liquid-rocketry-illinois/HAL-1-HW/KiCAD/Added_Footprints/BMI270/BMI323/BMI323.step

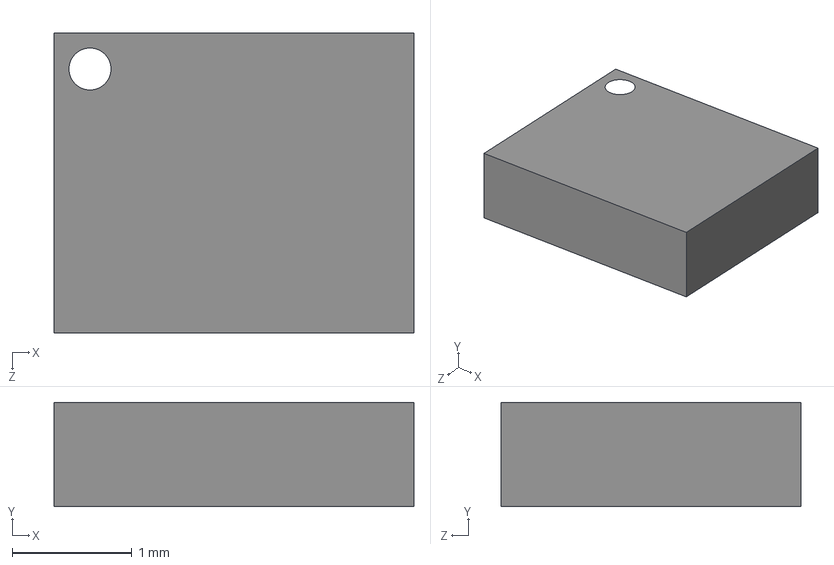
[picture p1: CAD file, 2026-01-19]
KiCAD/Added_Footprints/BMI270/BMI323/BMI323.step
3.00 x 0.87 x 2.50 mm
