liquid-rocketry-illinois/HAL-1-HW/(list of files, cad)

Other CAD files:
AV Bay CAD/AVBayAssembly.prt
AV Bay CAD/AVBayV2_BasePlate.prt
AV Bay CAD/AVBayV2_TopPlate.prt
AV Bay CAD/Antenna.prt
AV Bay CAD/Battery.prt
AV Bay CAD/Battery_Case_v2.prt
AV Bay CAD/Battery_Constrainer_v1.prt
AV Bay CAD/Battery_Plate.prt
AV Bay CAD/Done/AVBayV2_BasePlate.prt
AV Bay CAD/Done/AVBayV2_TopPlate.prt
AV Bay CAD/HAL-1_Case.prt
AV Bay CAD/Obseleted/[V1 Obselete] Board_Mounts.prt
AV Bay CAD/Screw_Switch.prt
AV Bay CAD/Telemega_Case.prt
