liquid-rocketry-illinois/HAL-1-HW/KiCAD/Soldering Practice Board/Main/Main.kicad_pcb

## KiCad design KiCAD/Soldering Practice Board/Main/Main.kicad_pcb (2026-03-03)

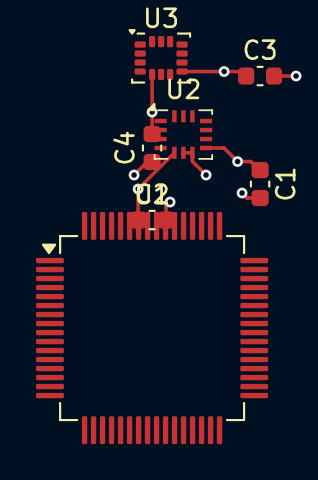
[picture p2: board KiCAD/Soldering Practice Board/Main/Main.kicad_pcb from above]

Board: 2 copper layers, 7 parts (0 on the bottom side), 2 nets.

Parts:
C1, C2, C3, C4: 100n; C_0603_1608Metric
U1: STM32C071R8Tx; LQFP-64_10x10mm_P0.5mm
U2: BMI160; Bosch_LGA-14_3x2.5mm_P0.5mm
U3: LSM6DS3; LGA-14_3x2.5mm_P0.5mm_LayoutBorder3x4y

Connections:
+3V3: C1.1, C2.1, C3.1, C4.2, U1.7 (VREF+), U1.8 (VDD), U2.5 (VDDIO), U2.8 (VDD), U3.5 (VDDIO), U3.8 (VDD)
GND: C1.2, C2.2, C3.2, C4.1, U1.9 (VSS), U2.6 (GNDIO), U2.7 (GND), U3.2 (SDX), U3.3 (SCX), U3.6 (GND), U3.7 (GND)
