liquid-rocketry-illinois/HAL-1-HW/KiCAD/Main/Main.kicad_pcb

## KiCad design KiCAD/Main/Main.kicad_pcb (2026-02-15)

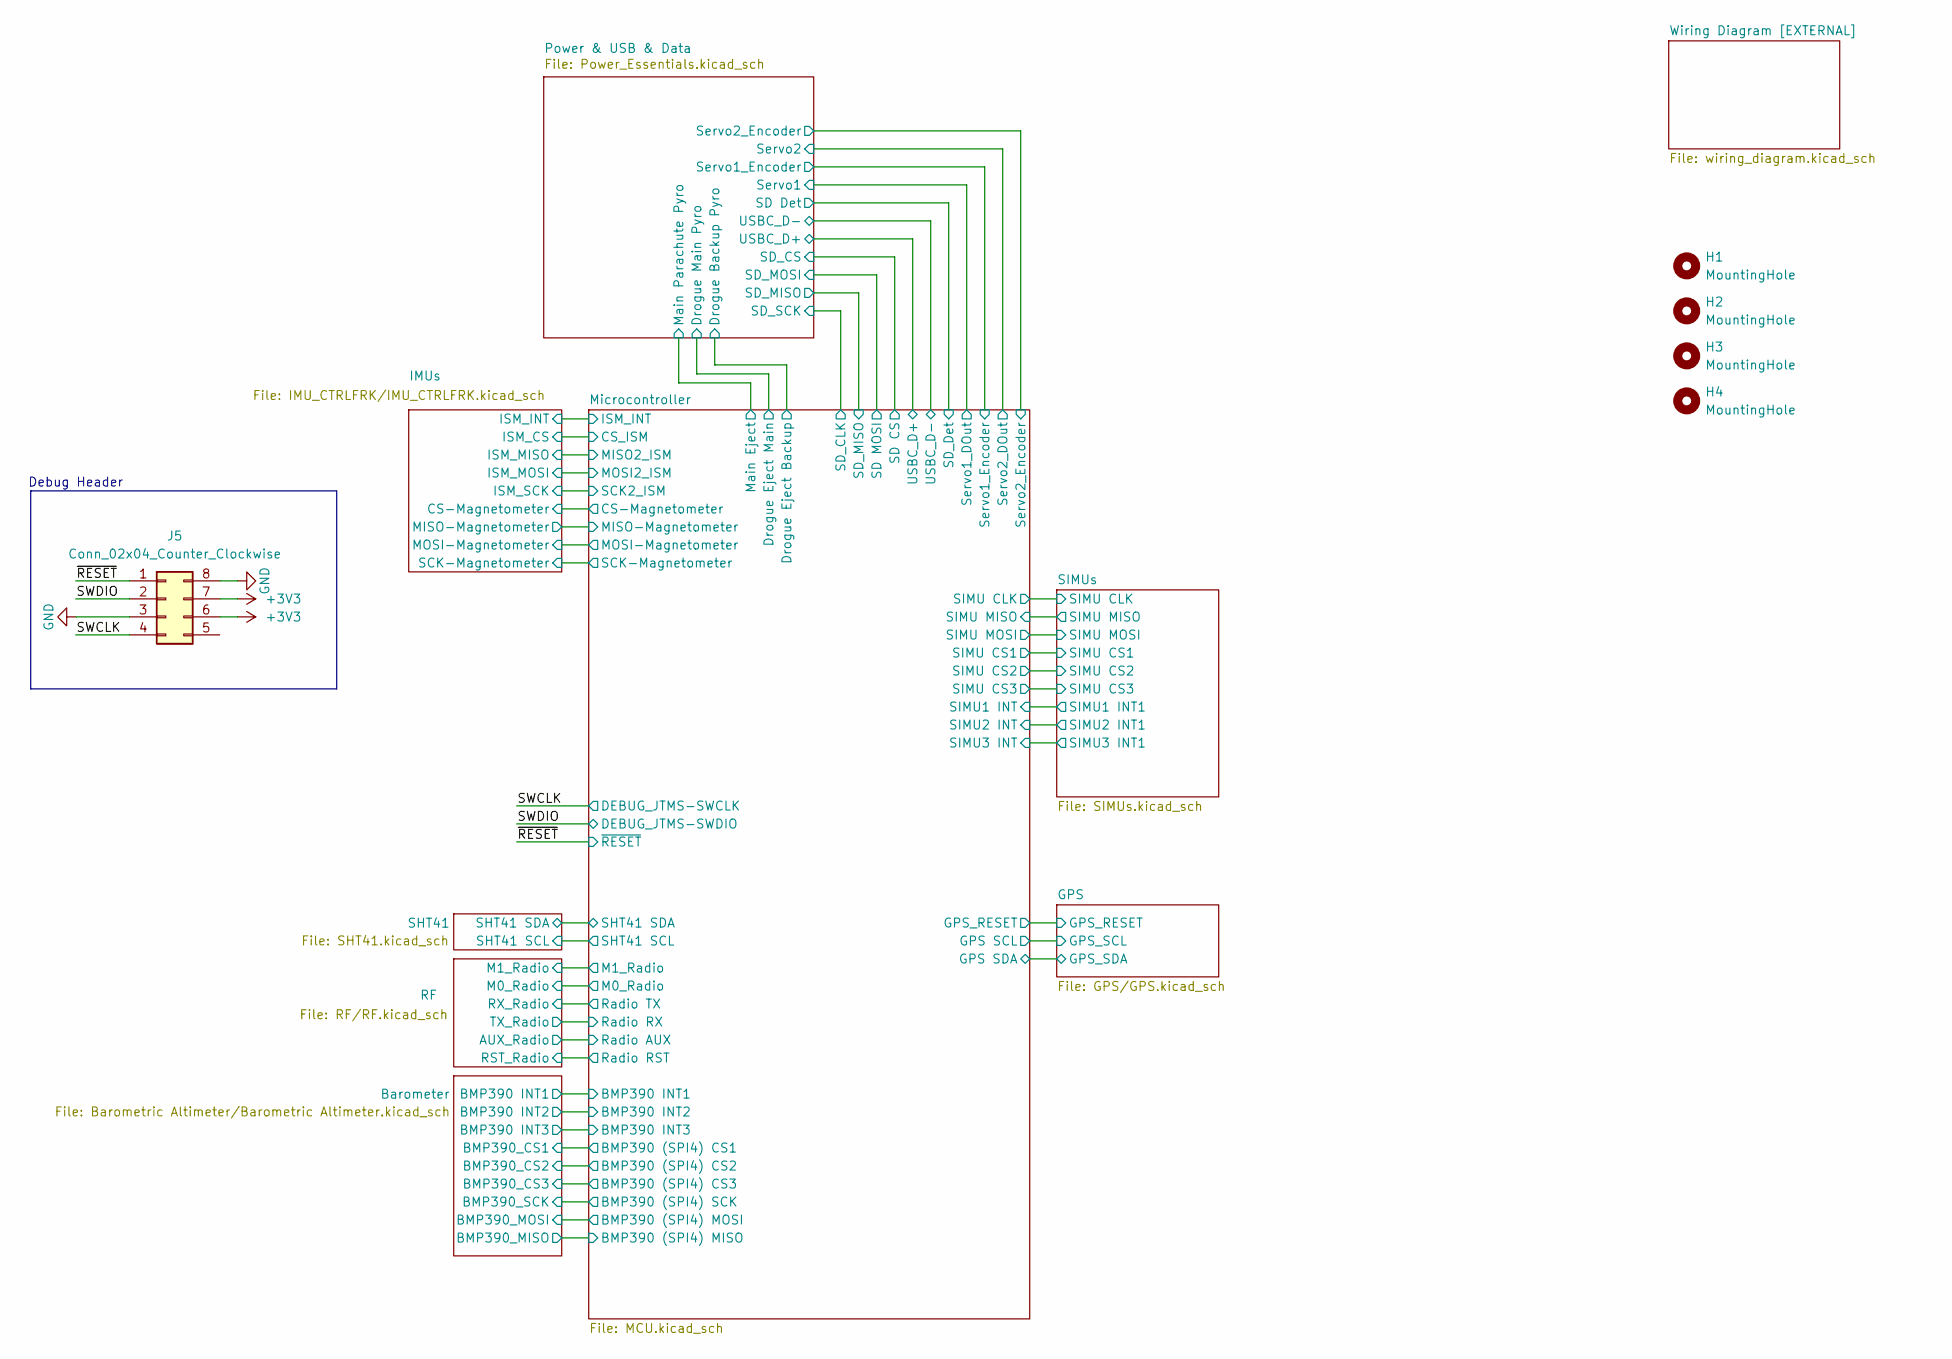
[picture p3: schematic Main.kicad_sch]

Parts:
H1, H2, H3, H4: MountingHole; MountingHole_3.2mm_M3
J5: Conn_02x04_Counter_Clockwise; PinHeader_2x04_P2.54mm_Vertical

Connections:
+3V3: J5.6, J5.7; also elsewhere on the board
/SWCLK: J5.4; also elsewhere on the board
/SWDIO: J5.2; also elsewhere on the board
/~RESET: J5.1; also elsewhere on the board
GND: J5.3, J5.8; also elsewhere on the board

Notes on the sheet:
Debug Header

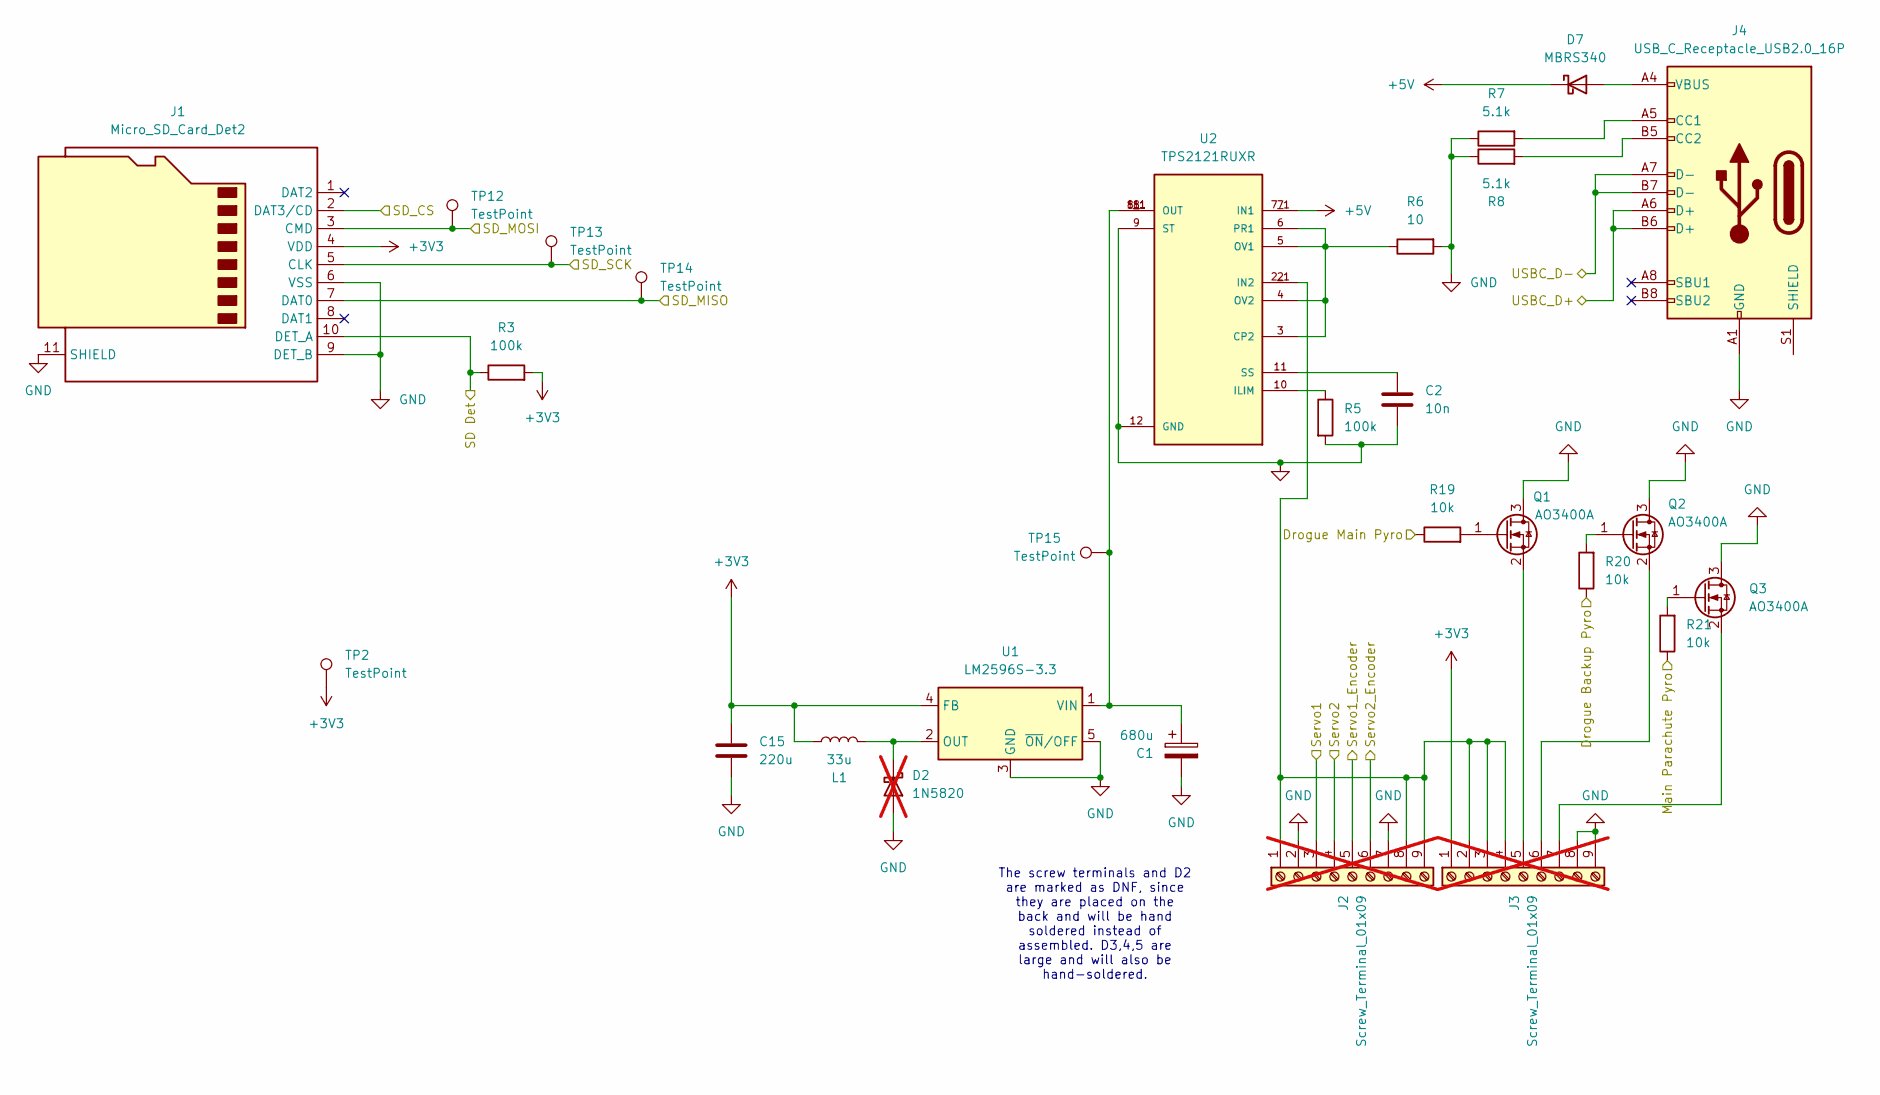
[picture p4: schematic Power_Essentials.kicad_sch]

Parts:
C1: 680u; CP_Elec_10x12.6
C2: 10n; C_0603_1608Metric
C15: 220u; C_1206_3216Metric
D2: 1N5820; D_DO-201AD_P15.24mm_Horizontal; not fitted
D7: MBRS340; D_SMC
J1: Micro_SD_Card_Det2; microSD_HC_Hirose_DM3AT-SF-PEJM5
J2, J3: Screw_Terminal_01x09; TerminalBlock_Phoenix_MKDS-1,5-9_1x09_P5.00mm_Horizontal; not fitted
J4: USB_C_Receptacle_USB2.0_16P; USB_C_Receptacle_HRO_TYPE-C-31-M-12
L1: 33u; L_SXN_SMDRI127
Q1, Q2, Q3: AO3400A; SOT-23
R3, R5: 100k; R_0603_1608Metric
R6: 10; R_0603_1608Metric
R7, R8: 5.1k; R_0603_1608Metric
R19, R20, R21: 10k; R_0603_1608Metric
TP2, TP12, TP13, TP14, TP15: TestPoint; TestPoint_Pad_D1.0mm
U1: LM2596S-3.3; TO-263-5_TabPin3
U2: TPS2121RUXR; Texas_VQFN-HR-12_2x2.5mm_P0.5mm_ThermalVias

Connections:
+3V3: C15.1, J1.4 (VDD), J3.1 (3V3_OUT), L1.1, R3.2, TP2.1, U1.4 (FB); also elsewhere on the board
+5V: D7.1 (K), U2.7 (IN1), U2.7_1 (IN1)
/Microcontroller/Drogue Eject Backup: R20.1; also elsewhere on the board
/Microcontroller/Drogue Eject Main: R19.1; also elsewhere on the board
/Microcontroller/Main Eject: R21.1; also elsewhere on the board
/Microcontroller/SD CS: J1.2 (DAT3/CD); also elsewhere on the board
/Microcontroller/SD MOSI: J1.3 (CMD), TP12.1; also elsewhere on the board
/Microcontroller/SD_CLK: J1.5 (CLK), TP13.1; also elsewhere on the board
/Microcontroller/SD_Det: J1.10 (DET_A), R3.1; also elsewhere on the board
/Microcontroller/SD_MISO: J1.7 (DAT0), TP14.1; also elsewhere on the board
/Microcontroller/Servo1_DOut: J2.3 (Servo1); also elsewhere on the board
/Microcontroller/Servo1_Encoder: J2.5 (Servo1_Encoder); also elsewhere on the board
/Microcontroller/Servo2_DOut: J2.4 (Servo2); also elsewhere on the board
/Microcontroller/Servo2_Encoder: J2.6 (Servo2_Encoder); also elsewhere on the board
/Microcontroller/USBC_D+: J4.A6 (D+), J4.B6 (D+); also elsewhere on the board
/Microcontroller/USBC_D-: J4.A7 (D-), J4.B7 (D-); also elsewhere on the board
GND: C1.2, C2.2, C15.2, D2.2 (A), J1.6 (VSS), J1.9 (DET_B), J1.11 (SHIELD), J2.2 (GND), J2.7 (MotorGND), J3.8, J3.9 (GND), J4.A1 (GND), J4.A12 (GND), J4.B1 (GND), J4.B12 (GND), Q1.3 (D), Q2.3 (D), Q3.3 (D), R5.2, R6.2, R7.1, R8.1, U1.3 (GND), U1.5 (~ON/OFF), U2.9 (ST), U2.12 (GND); also elsewhere on the board
unnamed: D2.1 (K), L1.2, U1.2 (OUT)
unnamed: D7.2 (A), J4.A4 (VBUS), J4.A9 (VBUS), J4.B4 (VBUS), J4.B9 (VBUS)
unnamed: J2.1 (7.4V_IN), J2.8 (MotorPwr1), J2.9 (MotorPwr2), J3.2 (Pyro_OUT_1), J3.3 (Pyro_OUT_2), J3.4 (Pyro_OUT_3), U2.2 (IN2), U2.2_1 (IN2)
unnamed: J3.6 (Drogue_Backup), Q2.2 (S)
unnamed: J3.5 (Drogue_Main), Q1.2 (S)
unnamed: J3.7 (Main_Parachute), Q3.2 (S)
unnamed: J4.A5 (CC1), R7.2
unnamed: J4.B5 (CC2), R8.2
unnamed: Q1.1 (G), R19.2
unnamed: Q2.1 (G), R20.2
unnamed: Q3.1 (G), R21.2
unnamed: C1.1, TP15.1, U1.1 (VIN), U2.1 (OUT), U2.1_1 (OUT), U2.8 (OUT), U2.8_1 (OUT)
unnamed: R6.1, U2.3 (CP2), U2.4 (OV2), U2.5 (OV1), U2.6 (PR1)
unnamed: R5.1, U2.10 (ILIM)
unnamed: C2.1, U2.11 (SS)

Notes on the sheet:
The screw terminals and D2 are marked as DNF, since they are placed on the back and will be hand soldered instead of assembled. D3,4,5 are large and will also be hand-soldered.

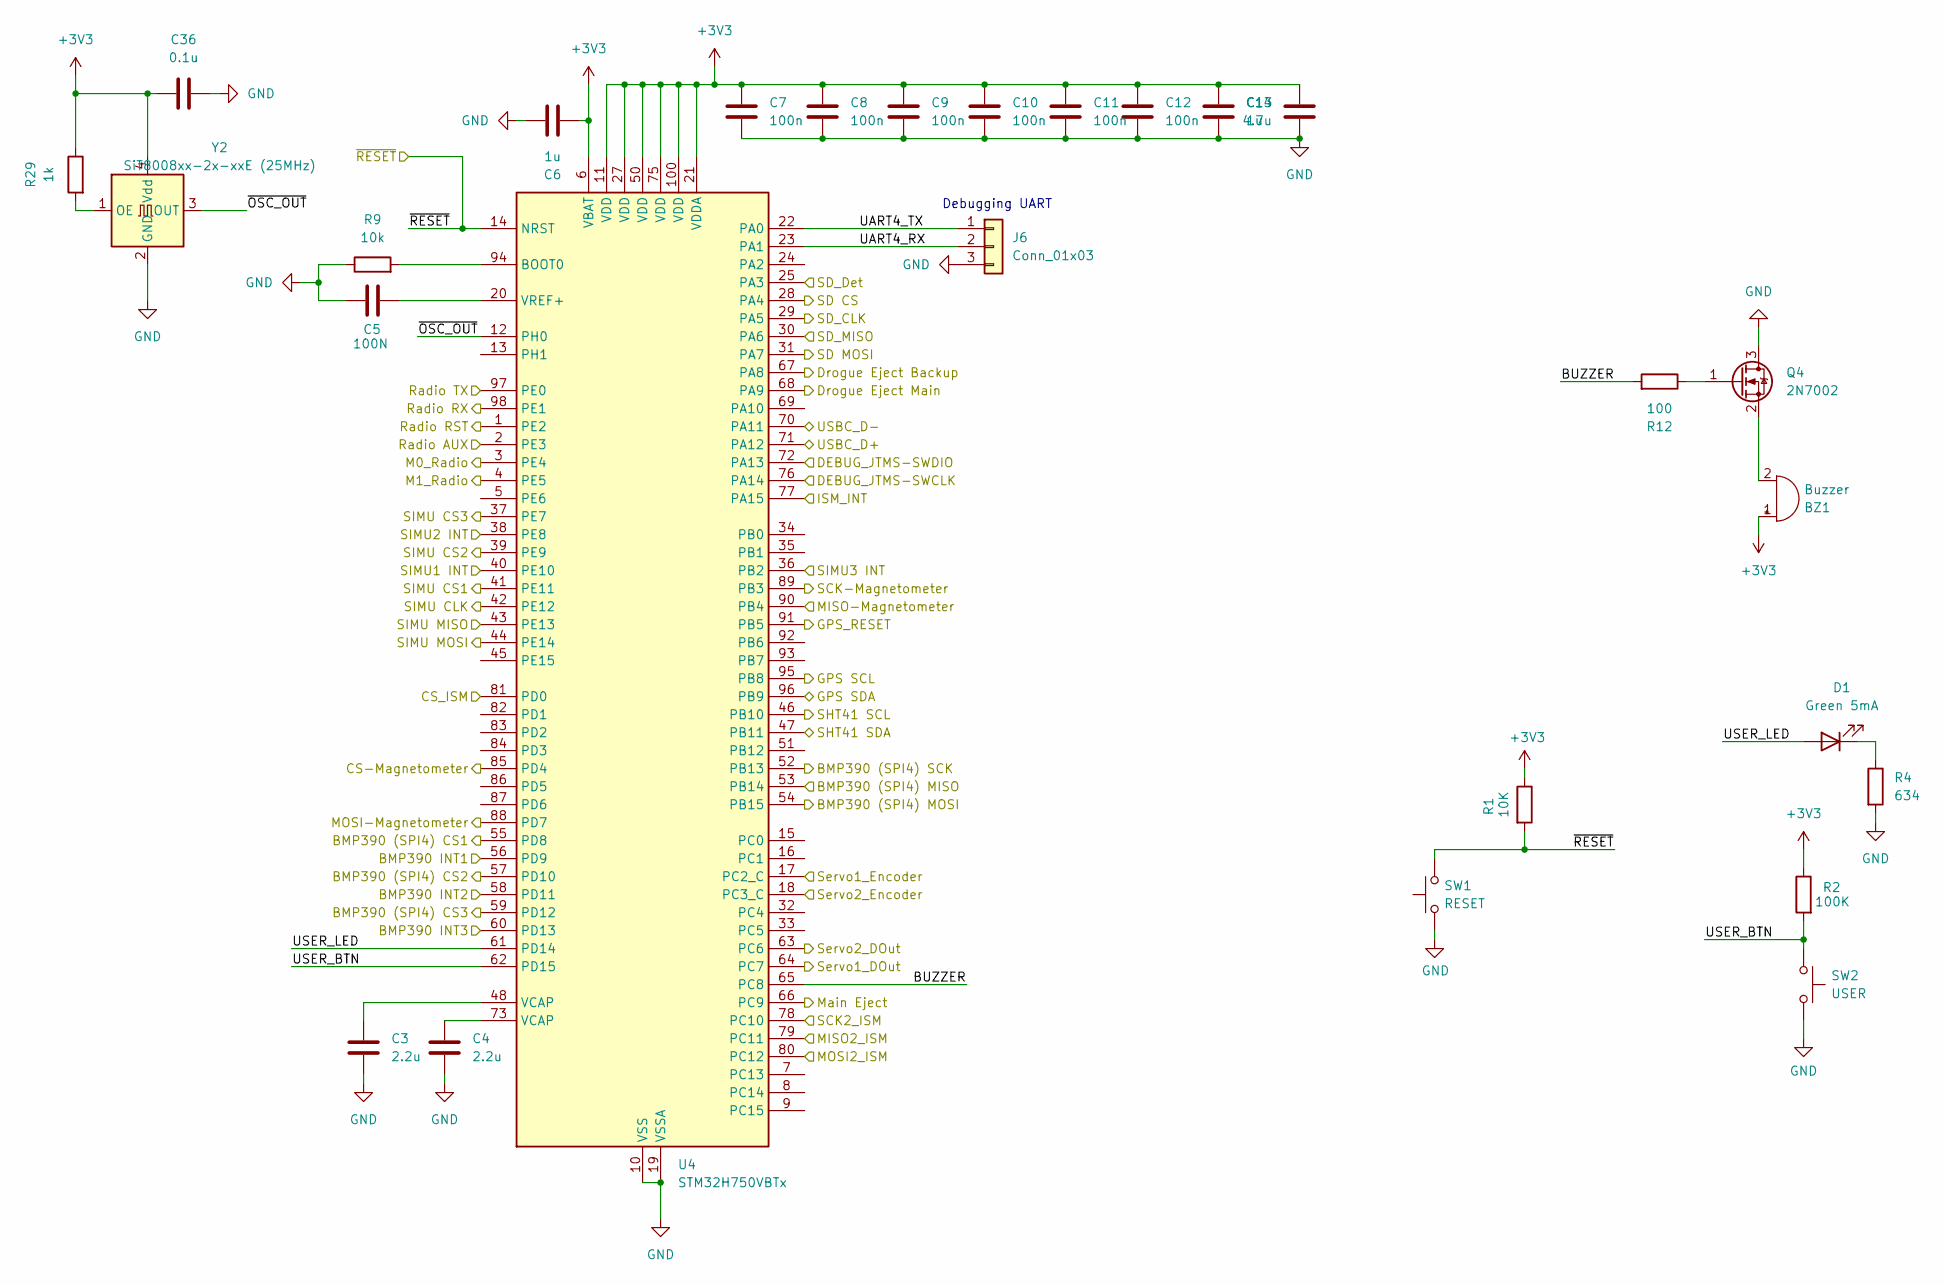
[picture p5: schematic MCU.kicad_sch]

Parts:
BZ1: Buzzer; Buzzer_12x9.5RM7.6
C3, C4: 2.2u; C_0603_1608Metric
C5: 100N; C_0603_1608Metric
C6, C13: 1u; C_0603_1608Metric
C7, C8, C9, C10, C11, C12: 100n; C_0603_1608Metric
C14: 4.7u; C_0603_1608Metric
C36: 0.1u; C_0603_1608Metric
D1: Green 5mA; LED_0603_1608Metric
J6: Conn_01x03; PinHeader_1x03_P2.54mm_Vertical
Q4: 2N7002; SOT-23
R1: 10K; R_0603_1608Metric
R2: 100K; R_0603_1608Metric
R4: 634; R_0603_1608Metric
R9: 10k; R_0603_1608Metric
R12: 100; R_0603_1608Metric
R29: 1k; R_0603_1608Metric
SW1: RESET; SW_Push_1P1T_NO_Vertical_Wuerth_434133025816
SW2: USER; SW_Push_1P1T_NO_Vertical_Wuerth_434133025816
U4: STM32H750VBTx; LQFP-100_14x14mm_P0.5mm
Y2: SiT8008xx-2x-xxE (25MHz); Oscillator_SMD_SiT_PQFN-4Pin_3.2x2.5mm

Connections:
+3V3: BZ1.1 (+), C6.2, C7.1, C8.1, C9.1, C10.1, C11.1, C12.1, C13.1, C14.1, C36.2, R1.1, R2.1, R29.1, U4.6 (VBAT), U4.11 (VDD), U4.21 (VDDA), U4.27 (VDD), U4.50 (VDD), U4.75 (VDD), U4.100 (VDD), Y2.4 (Vdd); also elsewhere on the board
/Barometer/BMP390 INT1: U4.56 (PD9); also elsewhere on the board
/Barometer/BMP390 INT2: U4.58 (PD11); also elsewhere on the board
/Barometer/BMP390 INT3: U4.60 (PD13); also elsewhere on the board
/Barometer/BMP390_CS1: U4.55 (PD8); also elsewhere on the board
/Barometer/BMP390_CS2: U4.57 (PD10); also elsewhere on the board
/Barometer/BMP390_CS3: U4.59 (PD12); also elsewhere on the board
/Barometer/BMP390_MISO: U4.53 (PB14); also elsewhere on the board
/Barometer/BMP390_MOSI: U4.54 (PB15); also elsewhere on the board
/Barometer/BMP390_SCK: U4.52 (PB13); also elsewhere on the board
/GPS/GPS_RESET: U4.91 (PB5); also elsewhere on the board
/GPS/GPS_SCL: U4.95 (PB8); also elsewhere on the board
/GPS/GPS_SDA: U4.96 (PB9); also elsewhere on the board
/IMUs/CS-Magnetometer: U4.85 (PD4); also elsewhere on the board
/IMUs/ISM_CS: U4.81 (PD0); also elsewhere on the board
/IMUs/ISM_INT: U4.77 (PA15); also elsewhere on the board
/IMUs/ISM_MISO: U4.79 (PC11); also elsewhere on the board
/IMUs/ISM_MOSI: U4.80 (PC12); also elsewhere on the board
/IMUs/ISM_SCK: U4.78 (PC10); also elsewhere on the board
/IMUs/MISO-Magnetometer: U4.90 (PB4); also elsewhere on the board
/IMUs/MOSI-Magnetometer: U4.88 (PD7); also elsewhere on the board
/IMUs/SCK-Magnetometer: U4.89 (PB3); also elsewhere on the board
/Microcontroller/BUZZER: R12.2, U4.65 (PC8)
/Microcontroller/Drogue Eject Backup: U4.67 (PA8); also elsewhere on the board
/Microcontroller/Drogue Eject Main: U4.68 (PA9); also elsewhere on the board
/Microcontroller/M0_Radio: U4.3 (PE4); also elsewhere on the board
/Microcontroller/M1_Radio: U4.4 (PE5); also elsewhere on the board
/Microcontroller/Main Eject: U4.66 (PC9); also elsewhere on the board
/Microcontroller/Radio AUX: U4.2 (PE3); also elsewhere on the board
/Microcontroller/Radio RST: U4.1 (PE2); also elsewhere on the board
/Microcontroller/Radio RX: U4.98 (PE1); also elsewhere on the board
/Microcontroller/Radio TX: U4.97 (PE0); also elsewhere on the board
/Microcontroller/SD CS: U4.28 (PA4); also elsewhere on the board
/Microcontroller/SD MOSI: U4.31 (PA7); also elsewhere on the board
/Microcontroller/SD_CLK: U4.29 (PA5); also elsewhere on the board
/Microcontroller/SD_Det: U4.25 (PA3); also elsewhere on the board
/Microcontroller/SD_MISO: U4.30 (PA6); also elsewhere on the board
/Microcontroller/SHT41 SCL: U4.46 (PB10); also elsewhere on the board
/Microcontroller/SHT41 SDA: U4.47 (PB11); also elsewhere on the board
/Microcontroller/SIMU1 INT: U4.40 (PE10); also elsewhere on the board
/Microcontroller/SIMU2 INT: U4.38 (PE8); also elsewhere on the board
/Microcontroller/SIMU3 INT: U4.36 (PB2); also elsewhere on the board
/Microcontroller/SIMU CLK: U4.42 (PE12); also elsewhere on the board
/Microcontroller/SIMU CS1: U4.41 (PE11); also elsewhere on the board
/Microcontroller/SIMU CS2: U4.39 (PE9); also elsewhere on the board
/Microcontroller/SIMU CS3: U4.37 (PE7); also elsewhere on the board
/Microcontroller/SIMU MISO: U4.43 (PE13); also elsewhere on the board
/Microcontroller/SIMU MOSI: U4.44 (PE14); also elsewhere on the board
/Microcontroller/Servo1_DOut: U4.64 (PC7); also elsewhere on the board
/Microcontroller/Servo1_Encoder: U4.17 (PC2_C); also elsewhere on the board
/Microcontroller/Servo2_DOut: U4.63 (PC6); also elsewhere on the board
/Microcontroller/Servo2_Encoder: U4.18 (PC3_C); also elsewhere on the board
/Microcontroller/UART4_RX: J6.2, U4.23 (PA1)
/Microcontroller/UART4_TX: J6.1, U4.22 (PA0)
/Microcontroller/USBC_D+: U4.71 (PA12); also elsewhere on the board
/Microcontroller/USBC_D-: U4.70 (PA11); also elsewhere on the board
/Microcontroller/USER_BTN: R2.2, SW2.2, U4.62 (PD15)
/Microcontroller/USER_LED: D1.2 (A), U4.61 (PD14)
/Microcontroller/~OSC_OUT: U4.12 (PH0), Y2.3 (OUT)
/SWCLK: U4.76 (PA14); also elsewhere on the board
/SWDIO: U4.72 (PA13); also elsewhere on the board
/~RESET: R1.2, SW1.2, U4.14 (NRST); also elsewhere on the board
GND: C3.2, C4.2, C5.1, C6.1, C7.2, C8.2, C9.2, C10.2, C11.2, C12.2, C13.2, C14.2, C36.1, J6.3, Q4.3 (D), R4.2, R9.1, SW1.1, SW2.1, U4.10 (VSS), U4.19 (VSSA), U4.26 (VSS), U4.49 (VSS), U4.74 (VSS), U4.99 (VSS), Y2.2 (GND); also elsewhere on the board
unnamed: BZ1.2 (-), Q4.2 (S)
unnamed: C3.1, U4.48 (VCAP)
unnamed: C4.1, U4.73 (VCAP)
unnamed: D1.1 (K), R4.1
unnamed: Q4.1 (G), R12.1
unnamed: R9.2, U4.94 (BOOT0)
unnamed: C5.2, U4.20 (VREF+)
unnamed: R29.2, Y2.1 (OE)

Notes on the sheet:
Debugging UART

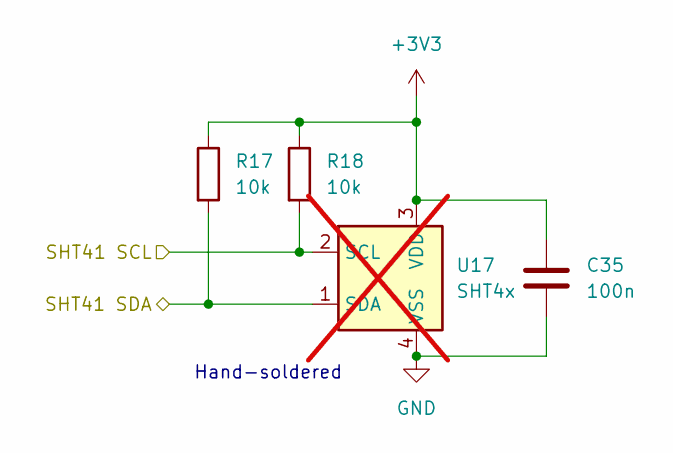
[picture p6: schematic SHT41.kicad_sch]

Parts:
C35: 100n; C_0603_1608Metric
R17, R18: 10k; R_0603_1608Metric
U17: SHT4x; Sensirion_DFN-4_1.5x1.5mm_P0.8mm_SHT4x_NoCentralPad; not fitted

Connections:
+3V3: C35.1, R17.1, R18.1, U17.3 (VDD); also elsewhere on the board
/Microcontroller/SHT41 SCL: R18.2, U17.2 (SCL); also elsewhere on the board
/Microcontroller/SHT41 SDA: R17.2, U17.1 (SDA); also elsewhere on the board
GND: C35.2, U17.4 (VSS); also elsewhere on the board

Notes on the sheet:
Hand-soldered

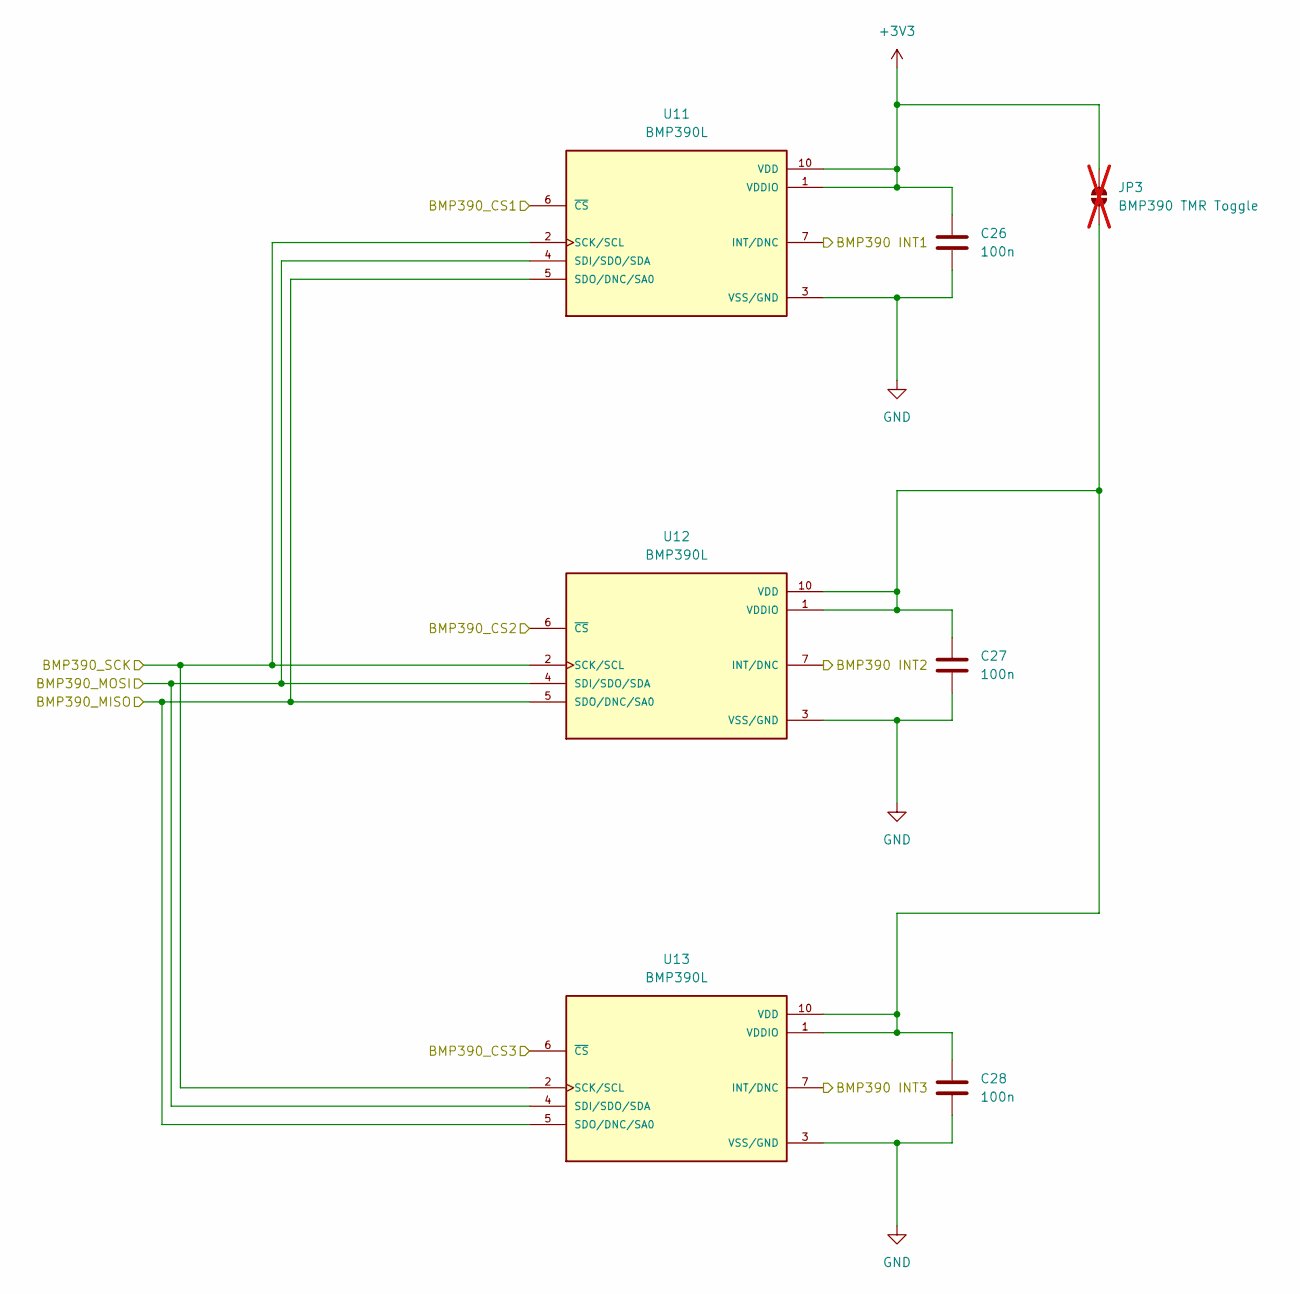
[picture p7: schematic Barometric Altimeter.kicad_sch, BMP 390 Barometric Altimeter]

Parts:
C26, C27, C28: 100n; C_0603_1608Metric
JP3: BMP390 TMR Toggle; SolderJumper-2_P1.3mm_Open_RoundedPad1.0x1.5mm; not fitted
U11, U12, U13: BMP390L; XDCR_BMP390L; PARTREV 1.7

Connections:
+3V3: C26.1, JP3.2 (B), U11.1 (VDDIO), U11.10 (VDD); also elsewhere on the board
/Barometer/BMP390 INT1: U11.7 (INT/DNC); also elsewhere on the board
/Barometer/BMP390 INT2: U12.7 (INT/DNC); also elsewhere on the board
/Barometer/BMP390 INT3: U13.7 (INT/DNC); also elsewhere on the board
/Barometer/BMP390_CS1: U11.6 (~CS); also elsewhere on the board
/Barometer/BMP390_CS2: U12.6 (~CS); also elsewhere on the board
/Barometer/BMP390_CS3: U13.6 (~CS); also elsewhere on the board
/Barometer/BMP390_MISO: U11.5 (SDO/DNC/SA0), U12.5 (SDO/DNC/SA0), U13.5 (SDO/DNC/SA0); also elsewhere on the board
/Barometer/BMP390_MOSI: U11.4 (SDI/SDO/SDA), U12.4 (SDI/SDO/SDA), U13.4 (SDI/SDO/SDA); also elsewhere on the board
/Barometer/BMP390_SCK: U11.2 (SCK/SCL), U12.2 (SCK/SCL), U13.2 (SCK/SCL); also elsewhere on the board
GND: C26.2, C27.2, C28.2, U11.3 (VSS/GND), U11.8 (VSS/GND), U11.9 (VSS/GND), U12.3 (VSS/GND), U12.8 (VSS/GND), U12.9 (VSS/GND), U13.3 (VSS/GND), U13.8 (VSS/GND), U13.9 (VSS/GND); also elsewhere on the board
unnamed: C27.1, C28.1, JP3.1 (A), U12.1 (VDDIO), U12.10 (VDD), U13.1 (VDDIO), U13.10 (VDD)

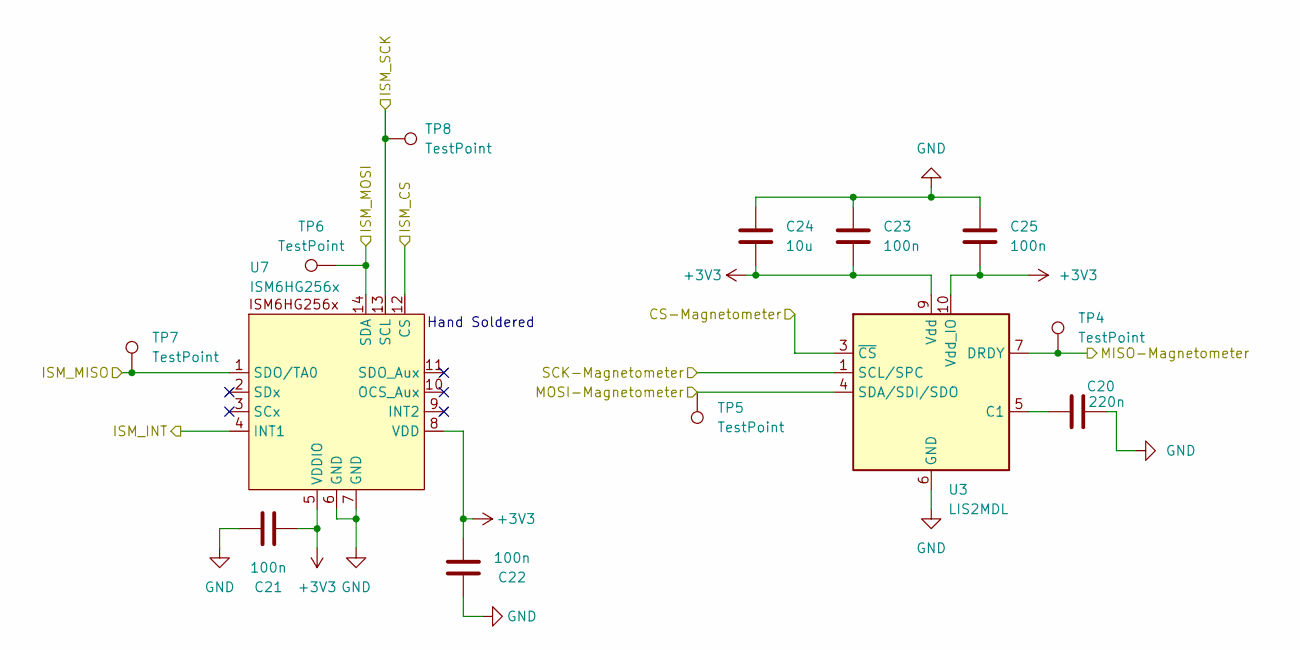
[picture p8: schematic IMU_CTRLFRK.kicad_sch]

Parts:
C20: 220n; C_0603_1608Metric
C21, C22, C23, C25: 100n; C_0603_1608Metric
C24: 10u; C_0603_1608Metric
TP4, TP5, TP6, TP7, TP8: TestPoint; TestPoint_Pad_D1.0mm
U3: LIS2MDL; LGA-12_2x2mm_P0.5mm
U7: ISM6HG256x; ISM6HG256XTR

Connections:
+3V3: C21.2, C22.2, C23.1, C24.1, C25.1, U3.9 (Vdd), U3.10 (Vdd_IO), U7.5 (VDDIO), U7.8 (VDD); also elsewhere on the board
/IMUs/CS-Magnetometer: U3.3 (~CS); also elsewhere on the board
/IMUs/ISM_CS: U7.12 (CS); also elsewhere on the board
/IMUs/ISM_INT: U7.4 (INT1); also elsewhere on the board
/IMUs/ISM_MISO: TP7.1, U7.1 (SDO/TA0); also elsewhere on the board
/IMUs/ISM_MOSI: TP6.1, U7.14 (SDA); also elsewhere on the board
/IMUs/ISM_SCK: TP8.1, U7.13 (SCL); also elsewhere on the board
/IMUs/MISO-Magnetometer: TP4.1, U3.7 (DRDY); also elsewhere on the board
/IMUs/MOSI-Magnetometer: TP5.1, U3.4 (SDA/SDI/SDO); also elsewhere on the board
/IMUs/SCK-Magnetometer: U3.1 (SCL/SPC); also elsewhere on the board
GND: C20.2, C21.1, C22.1, C23.2, C24.2, C25.2, U3.6 (GND), U3.8 (GND), U7.6 (GND), U7.7 (GND); also elsewhere on the board
unnamed: C20.1, U3.5 (C1)

Notes on the sheet:
Hand Soldered

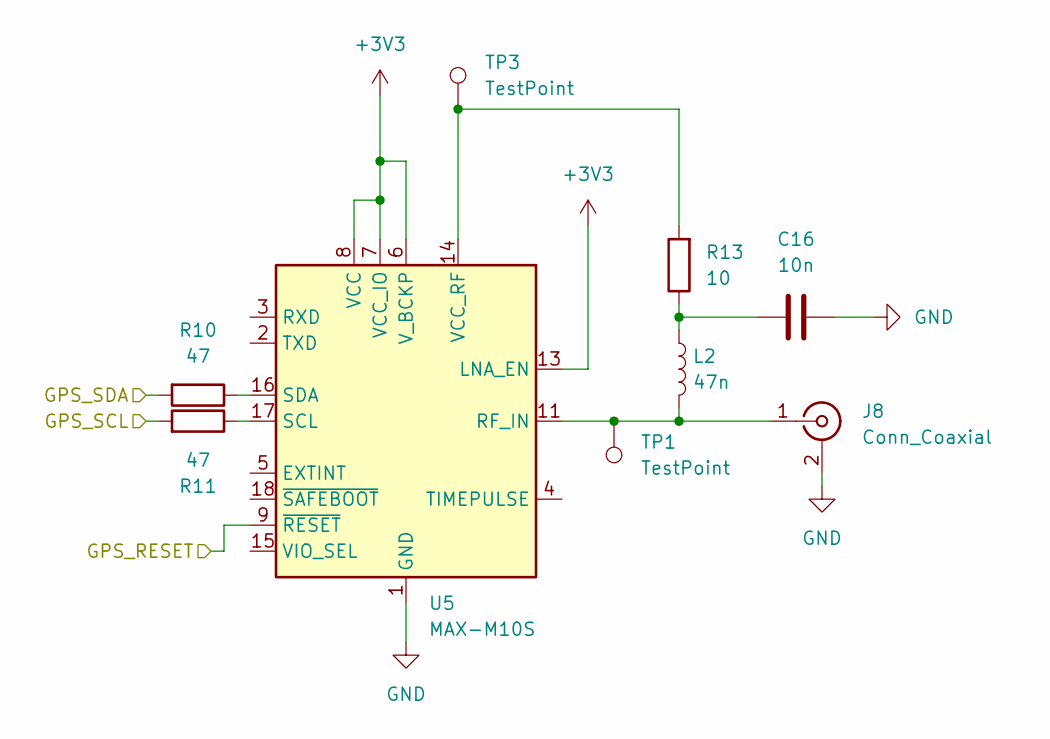
[picture p9: schematic GPS.kicad_sch]

Parts:
C16: 10n; C_0603_1608Metric
J8: Conn_Coaxial; U.FL_Molex_MCRF_73412-0110_Vertical
L2: 47n; L_0603_1608Metric
R10, R11: 47; R_0603_1608Metric
R13: 10; R_0603_1608Metric
TP1, TP3: TestPoint; TestPoint_Pad_D1.0mm
U5: MAX-M10S; ublox_MAX

Connections:
+3V3: U5.6 (V_BCKP), U5.7 (VCC_IO), U5.8 (VCC), U5.13 (LNA_EN); also elsewhere on the board
/GPS/GPS_RESET: U5.9 (~RESET); also elsewhere on the board
/GPS/GPS_SCL: R11.2; also elsewhere on the board
/GPS/GPS_SDA: R10.2; also elsewhere on the board
GND: C16.2, J8.2 (Ext), U5.1 (GND), U5.10 (GND), U5.12 (GND); also elsewhere on the board
unnamed: C16.1, L2.1, R13.1
unnamed: J8.1 (In), L2.2, TP1.1, U5.11 (RF_IN)
unnamed: R11.1, U5.17 (SCL)
unnamed: R10.1, U5.16 (SDA)
unnamed: R13.2, TP3.1, U5.14 (VCC_RF)

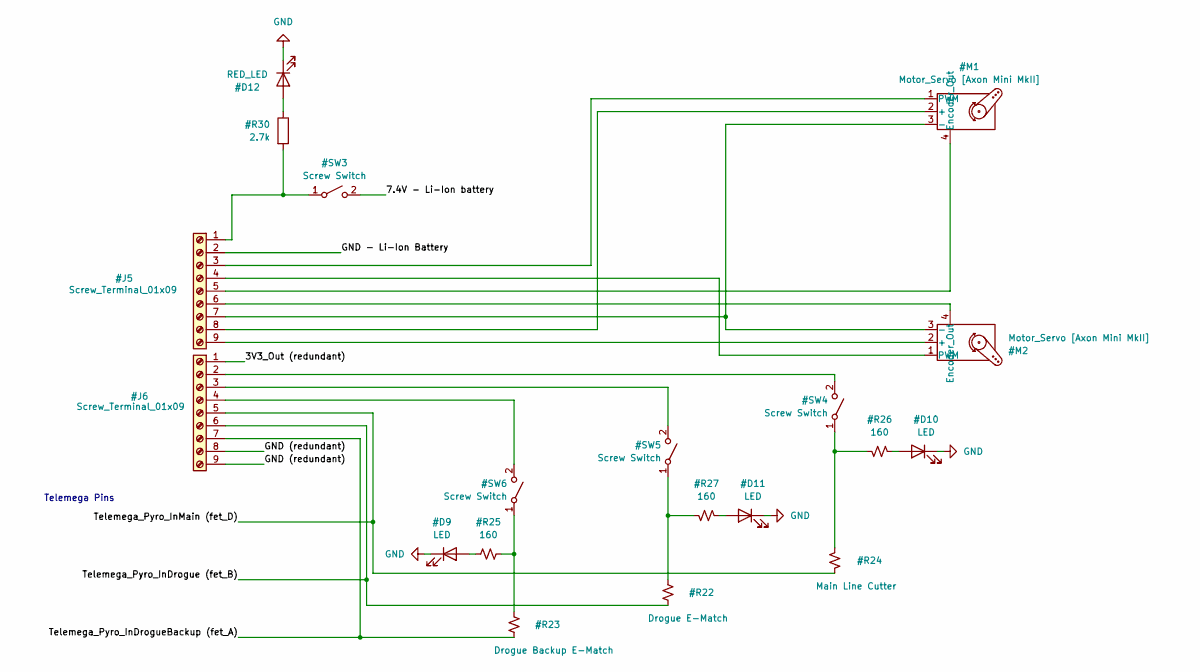
[picture p10: schematic wiring_diagram.kicad_sch]

Notes on the sheet:
Telemega Pins

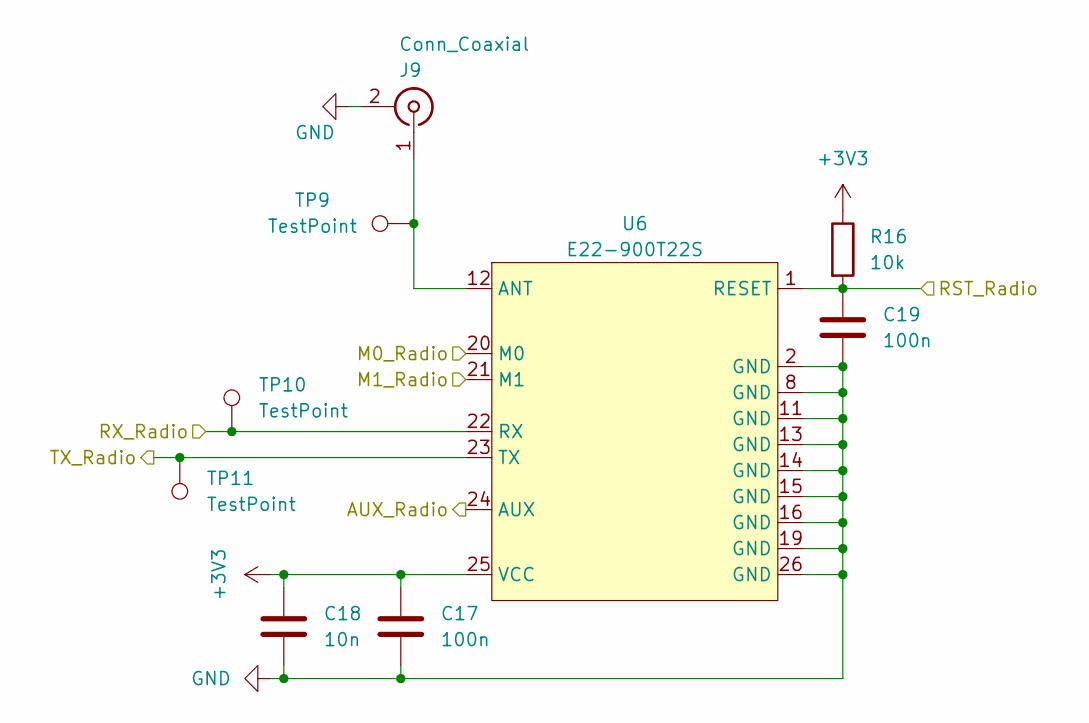
[picture p11: schematic RF.kicad_sch, Ebyte E22 Radio Module]

Parts:
C17, C19: 100n; C_0603_1608Metric
C18: 10n; C_0603_1608Metric
J9: Conn_Coaxial; U.FL_Molex_MCRF_73412-0110_Vertical
R16: 10k; R_0603_1608Metric
TP9, TP10, TP11: TestPoint; TestPoint_Pad_D1.0mm
U6: E22-900T22S

Connections:
+3V3: C17.1, C18.1, R16.1, U6.25 (VCC); also elsewhere on the board
/Microcontroller/M0_Radio: U6.20 (M0); also elsewhere on the board
/Microcontroller/M1_Radio: U6.21 (M1); also elsewhere on the board
/Microcontroller/Radio AUX: U6.24 (AUX); also elsewhere on the board
/Microcontroller/Radio RST: C19.1, R16.2, U6.1 (RESET); also elsewhere on the board
/Microcontroller/Radio RX: TP11.1, U6.23 (TX); also elsewhere on the board
/Microcontroller/Radio TX: TP10.1, U6.22 (RX); also elsewhere on the board
GND: C17.2, C18.2, C19.2, J9.2 (Ext), U6.2 (GND), U6.8 (GND), U6.11 (GND), U6.13 (GND), U6.14 (GND), U6.15 (GND), U6.16 (GND), U6.19 (GND), U6.26 (GND); also elsewhere on the board
unnamed: J9.1 (In), TP9.1, U6.12 (ANT)
