liquid-rocketry-illinois/HAL-1-HW/KiCAD/Main/Main.kicad_pcb

## KiCad design KiCAD/Main/Main.kicad_pcb (continued)

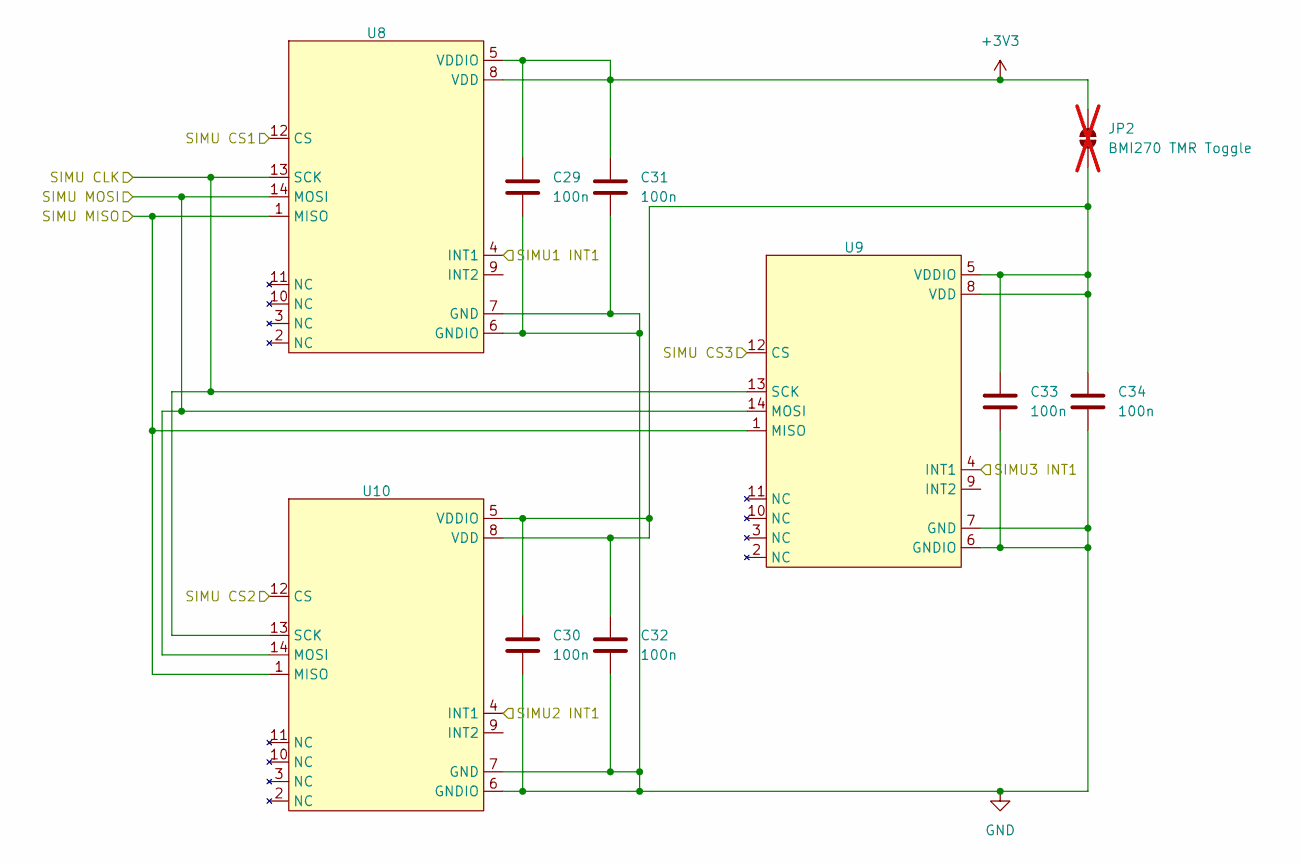
[picture p12: schematic SIMUs.kicad_sch]

Parts:
C29, C30, C31, C32, C33, C34: 100n; C_0603_1608Metric
JP2: BMI270 TMR Toggle; SolderJumper-2_P1.3mm_Open_RoundedPad1.0x1.5mm; not fitted
U8, U9, U10: BMI323

Connections:
+3V3: C29.1, C31.1, JP2.2 (B), U8.5 (VDDIO), U8.8 (VDD); also elsewhere on the board
/Microcontroller/SIMU1 INT: U8.4 (INT1); also elsewhere on the board
/Microcontroller/SIMU2 INT: U10.4 (INT1); also elsewhere on the board
/Microcontroller/SIMU3 INT: U9.4 (INT1); also elsewhere on the board
/Microcontroller/SIMU CLK: U8.13 (SCK), U9.13 (SCK), U10.13 (SCK); also elsewhere on the board
/Microcontroller/SIMU CS1: U8.12 (CS); also elsewhere on the board
/Microcontroller/SIMU CS2: U10.12 (CS); also elsewhere on the board
/Microcontroller/SIMU CS3: U9.12 (CS); also elsewhere on the board
/Microcontroller/SIMU MISO: U8.1 (MISO), U9.1 (MISO), U10.1 (MISO); also elsewhere on the board
/Microcontroller/SIMU MOSI: U8.14 (MOSI), U9.14 (MOSI), U10.14 (MOSI); also elsewhere on the board
GND: C29.2, C30.2, C31.2, C32.2, C33.2, C34.2, U8.6 (GNDIO), U8.7 (GND), U9.6 (GNDIO), U9.7 (GND), U10.6 (GNDIO), U10.7 (GND); also elsewhere on the board
unnamed: C30.1, C32.1, C33.1, C34.1, JP2.1 (A), U9.5 (VDDIO), U9.8 (VDD), U10.5 (VDDIO), U10.8 (VDD)

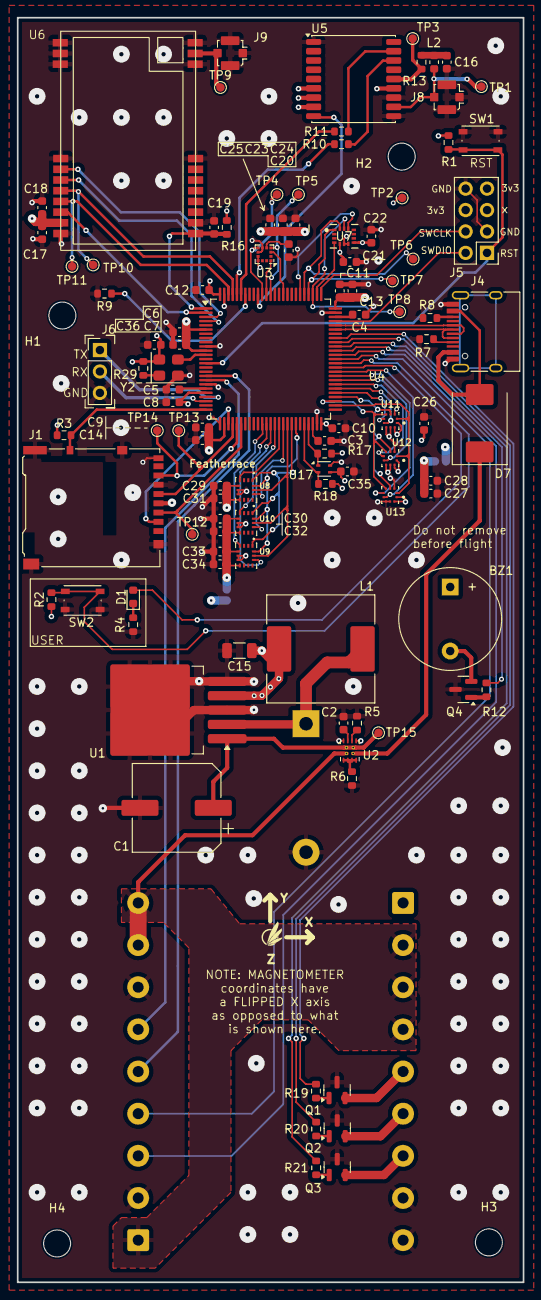
[picture p13: board KiCAD/Main/Main.kicad_pcb from above]

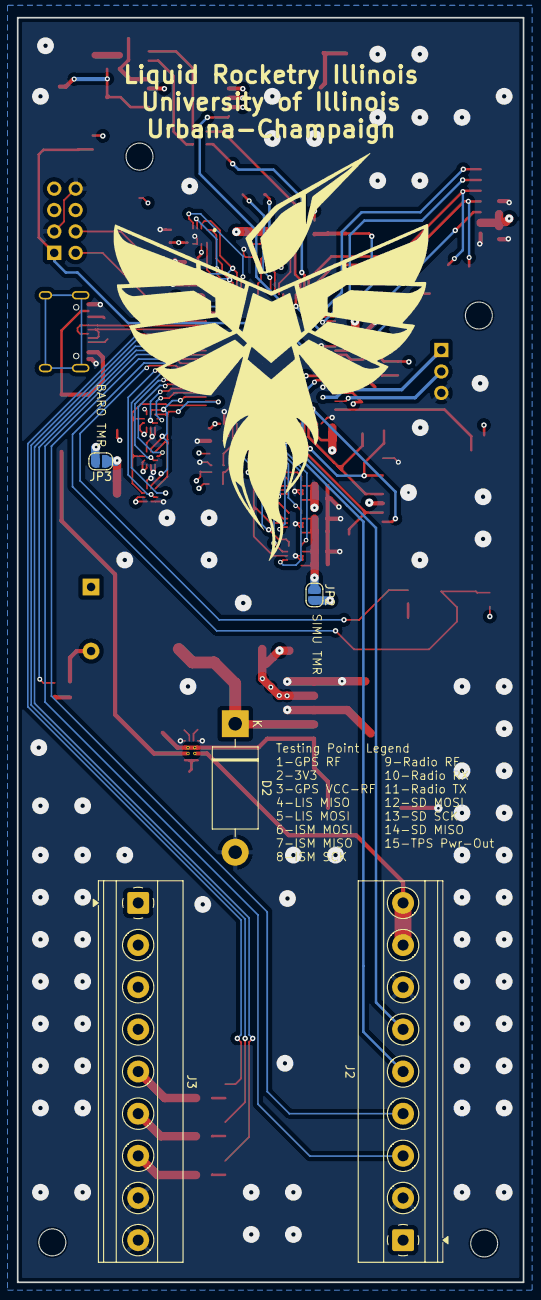
[picture p14: board KiCAD/Main/Main.kicad_pcb from below]

Board: 4 copper layers, 60.0 x 150.0 mm, 112 parts (5 on the bottom side), 96 nets.
