liquid-rocketry-illinois/HAL-1-HW/KiCAD/Soldering Practice Board/Soldering Practice Board.ioc

Mcu.UserName=STM32C071R8Tx
PA13.Signal=DEBUG_SWDIO
PA14-BOOT0.Signal=DEBUG_SWCLK
PA8.Signal=S_TIM1_CH1
PB3.Signal=SPI1_SCK
PB6.Signal=I2C1_SCL
PB7.Signal=I2C1_SDA
PC4.Signal=USART1_TX
PC5.Signal=USART1_RX
PC6.Signal=S_TIM2_CH3
PC9.GPIO_Label=STLIS_INT1
PC9.Signal=GPXTI9
PD0.GPIO_Label=BMI_INT1
PD0.Signal=GPXTI0
PD3.GPIO_Label=STLIS_CS
PD3.Signal=GPIO_Output
PD4.GPIO_Label=BMI_CS
PD4.Signal=GPIO_Output
PD5.Signal=SPI1_MISO
PD6.Signal=SPI1_MOSI
PF0-OSC_IN(PF0).Signal=RCC_OSC_IN
PF1-OSC_OUT(PF1).Signal=RCC_OSC_OUT
