liquid-rocketry-illinois/HAL-1-HW/(commit log)

2025-12-29 Complete layout first draft
    [IMU_CTRLFRK.kicad_sch, MCU.kicad_sch, Main.kicad_pcb, Main.kicad_sch, RF.kicad_sch, SIMUs.kicad_sch, wiring_diagram.kicad_sch]
2025-12-29 Changed out conenctor footprint for smaller, vertical THT component
    [Main.kicad_sch]
2025-12-29 Marked components as ignored from board
    [wiring_diagram.kicad_sch]
2025-12-29 Moved custom footprints into local KiCAD footprint library
    [Barometric Altimeter.kicad_sch, IMU_CTRLFRK.kicad_sch, Power_Essentials.kicad_sch, RF.kicad_sch, SIMUs.kicad_sch]
2025-12-29 Fixed footprints for terminal blocks
    [Power_Essentials.kicad_sch]
2025-12-30 Moved MISO1 to better position
    [MCU.kicad_sch, wiring_diagram.kicad_sch]
2025-12-30 Moved GPS I2C to more optimal location
    [MCU.kicad_sch]
2025-12-30 Fixed controller SCL/SDA pins
    [IMU_CTRLFRK.kicad_sch]
2025-12-30 Moved around some more pins for easier routing
    [MCU.kicad_sch, Main.kicad_sch]
2025-12-30 Initial component placement
    [Main.kicad_pcb]
2025-12-30 Changed debug header out for 2x4 to save space
    [Main.kicad_sch, wiring_diagram.kicad_sch]
2025-12-30 Changed BMM350 for LIS2MDL
    [IMU_CTRLFRK.kicad_sch, MCU.kicad_sch, Main.kicad_sch]
2025-12-30 Fixed routing for LIS2MDL
    [Main.kicad_pcb]
2025-12-30 DRC and ground fills
    [Main.kicad_pcb]
2025-12-31 Layout and routing
    [Barometric Altimeter.kicad_sch, MCU.kicad_sch, Main.kicad_pcb, Main.kicad_sch, Power_Essentials.kicad_sch, SIMUs.kicad_sch, wiring_diagram.kicad_sch]
2026-01-03 Arrange silkscreen & review
    [Main.kicad_pcb]
2026-01-07 Update aux magnetometer, test THs, and silkscreens
    [.kicad_sch, Camera.kicad_sch, GPS.kicad_sch, IMU_CTRLFRK.kicad_sch, MCU.kicad_sch, Main.kicad_pcb, Main.kicad_sch, Power_Essentials.kicad_sch]
2026-01-08 Replace independent magnetometer, reformat test points, generate test gerber and BOM
    [GPS.kicad_sch, HAL-1.csv, IMU_CTRLFRK.kicad_sch, MCU.kicad_sch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]
2026-01-09 Update BOM and respective components according to LCSC supply, remove previously generated production files
    [BOM-Main.csv, GPS.kicad_sch, IMU_CTRLFRK.kicad_sch, MCU.kicad_sch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]
2026-01-10 create servo test folder
2026-01-14 save progress
    [Main.kicad_pcb]
2026-01-14 save after realizing branch was not switched to layoutv2
    [GPS.kicad_sch, IMU_CTRLFRK.kicad_sch, Main.kicad_pcb, Power_Essentials.kicad_sch, RF.kicad_sch, SHT41.kicad_sch, wiring_diagram.kicad_sch]
2026-01-15 Update datasheets and build theoretically working servo test code
2026-01-19 Edit PCB Layout to increase min hole size and decrease price, prepare production files, prepare for main branch merge
    [BOM-Main.csv, HAL-1.csv, IMU_CTRLFRK.kicad_sch, MCU.kicad_sch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]
2026-01-19 Reorganize libraries into LRI.pretty, replace BMI270 with BMI323
    [BMI323.step, BOM-Main.csv, IMU_CTRLFRK.kicad_sch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]
2026-01-30 Upload (still) nonfunctional PWM for debug
2026-02-10 Add board mount part file
    temporary file that will be sorted/replaced later
    [Board_Mounts.prt]
2026-02-10 Add new CAD files for temporary upload
    [AVBayV2_BasePlate.prt, AVBayV2_TopPlate.prt]
2026-02-11 Add add'l files from meeting
    [Battery_Case_v2.prt, Battery_Constrainer_v1.prt, Battery_Plate.prt]
2026-02-11 Organize prt files into folder
    [AVBayV2_BasePlate.prt, AVBayV2_TopPlate.prt, Battery_Case_v2.prt, Battery_Constrainer_v1.prt, Battery_Plate.prt, [V1] Board_Mounts.prt]
2026-02-15 Review CAD part 1
    [AVBayAssembly.prt, AVBayV2_BasePlate.prt, AVBayV2_TopPlate.prt, Battery.prt, Battery_Case_v2.prt, Battery_Constrainer_v1.prt, Battery_Plate.prt, HAL-1_Case.prt]
2026-02-15 Review CAD files part 2
    [AVBayAssembly.prt, AVBayV2_BasePlate.prt, HAL-1_Case.prt, Main.kicad_pcb, Telemega_Case.prt]
2026-02-17 Add new KiCAD project for soldering practice board
    [Main.kicad_pcb, Main.kicad_sch]
2026-02-17 Write BMi260 explanations
    [BMI270.kicad_sch, Main.kicad_sch]
2026-02-17 create lsm spi schematic for practice board
    [Main.kicad_sch, STLSM6DS3TR-C.kicad_sch]
2026-02-17 create lsm spi practice board schematic
2026-02-17 Complete BMI260 Explanation
    [BMI270.kicad_sch]
2026-02-17 Push reviewed CAD
    [AVBayAssembly.prt, AVBayV2_BasePlate.prt, AVBayV2_TopPlate.prt, Battery.prt, Battery_Case_v2.prt, Battery_Constrainer_v1.prt, Battery_Plate.prt, Telemega_Case.prt]
2026-02-18 Add screw switch mounts, adjust top plate size
    [AVBayAssembly.prt, AVBayV2_BasePlate.prt, AVBayV2_TopPlate.prt, Battery_Constrainer_v1.prt, Battery_Plate.prt, HAL-1_Case.prt, Telemega_Case.prt]
2026-02-19 Add antenna
    [AVBayAssembly.prt, Antenna.prt]
2026-02-19 Extend screw switch thickness 4mm
    [AVBayAssembly.prt, Battery_Plate.prt]
2026-02-19 Add antenna constrainer
    [AVBayV2_TopPlate.prt]
2026-02-19 Add spacer to top plate
    [AVBayV2_TopPlate.prt]
2026-02-20 Add screw switch model and explode assembly
    [AVBayAssembly.prt, AVBayV2_BasePlate.prt, AVBayV2_TopPlate.prt, Antenna.prt, Battery.prt, Battery_Case_v2.prt, Battery_Constrainer_v1.prt, Battery_Plate.prt]
2026-02-24 Make LIS3 labels more concise
    [STLSM6DS3TR-C.kicad_sch]
2026-02-24 copy mode 1 schematic for lsm
    [STLSM6DS3TR-C.kicad_sch]
2026-03-03 Add BMP schematic
    [BMP581.kicad_sch, Main.kicad_sch]
2026-03-03 Configure IOC file, rename pins
    [BMI270.kicad_sch, Main.kicad_pcb, Main.kicad_sch, STLSM6DS3TR-C.kicad_sch]
2026-03-03 create stl footprints
    [BMI270.kicad_sch, STLSM6DS3TR-C.kicad_sch]
2026-03-03 begin stl pcb layout
    [Main.kicad_pcb]
2026-03-03 Define more mcu pins
    [Main.kicad_pcb, Main.kicad_sch]
