liquid-rocketry-illinois/HAL-1-HW/(notices)

Notices in the files:
temp_H755_Test/H755_ServoTest/CM7/Core/Src/main.c:
Copyright (c) 2026 STMicroelectronics.
All rights reserved.
This software is licensed under terms that can be found in the LICENSE file
